fontsa1/KRIA-Based-Bathymetric-Surveying-ASV/Part List.docx

Purchase prices checked 28 Sep 2026, before shipping and tax.

Sonar Sensor:

BlueRobotics Ping2 echosounder/altimeter

https://bluerobotics.com/store/sonars/echosounders/ping-sonar-r2-rp/

Purchase: already have (from the old boat)

Path:

USB, USB -> serial adapter

https://bluerobotics.com/store/comm-control-power/tether-interface/bluart-r1-rp/

Purchase: $56 at Blue Robotics (link above)

Thruster:

BlueRobotics T200 thruster 1x

https://bluerobotics.com/store/thrusters/t100-t200-thrusters/t200-thruster-r2-rp/

Purchase: $230 at Blue Robotics (link above)

Path:

PWM from the interface board's mux (KR260 or RC receiver) -> Basic ESC -> thruster

Thruster ESC:

BlueRobotics Basic ESC 1x

https://bluerobotics.com/store/thrusters/speed-controllers/besc30-r3/

Purchase: $40 at Blue Robotics (link above)

(the team already has one, on the existing thruster; the boat needs two)

Path:

Signal: PWM from the interface board's mux (3-pin servo lead, signal and ground only)

Power: 30 A circuit on the fuse block; re-crimp the 14 AWG power leads with #8 ring terminals

Motor: solder the three motor wires to the thruster's wires

GPS:

u-blox NEO

https://gnss.store/products/elt0380

Purchase: €89.99 at GNSS Store, shipped from the EU (link above)

Path:

USB-C, to the shore laptop (the GPS stays off the boat)

GPS Antenna:

Adafruit active GPS antenna (28 dB, 5 m cable, SMA, magnetic base) 1x

https://www.adafruit.com/product/960

Purchase: $21.50 at Adafruit (link above)

(not rated waterproof; the IP67 u-blox ANN-MB-00, €53.80 at ArduSimple, is the upgrade)

Path:

SMA male, 5 m cable -> the GPS receiver's SMA connector

LIDAR:

https://www.dfrobot.com/product-2616.html

Purchase: $399 at DFRobot (link above)

Path:

TTL UART, ships with a USB adapter and micro-USB cable

Power: the kit's power cable from the USB charger (Blue Sea 1045)

Synthetic GPS:

Marvelmind Super-Beacon

https://www.robotshop.com/products/marvelmind-super-beacon-45khz?qd=e18b03a20aebe5a5d66a8ae218f72a98

Purchase: already have

Path:

Virtual UART via USB

Marvelmind Modem:

Marvelmind Modem HW v5.1

https://marvelmind.com/product/modem-hw-v5-1/

Purchase: $119 at Marvelmind, only if the set is missing it (link above)

(comes in the Starter Set Super-MP-3D; buy one only if the team's set is missing it)

Path:

USB to the shore laptop (Marvelmind Dashboard) for setup; a USB power bank keeps it on during a survey

Number of stationary beacons still depends on the survey area (plan §8.1)

RC Reciever:

RadioMaster ER8 ELRS PWM receiver 1x

https://radiomasterrc.com/products/er8-2-4ghz-elrs-pwm-receiver

Purchase: $34.99 at RadioMaster; US hobby stores charge $41.99 (link above)

Path:

PWM outputs -> interface board: left thrust, right thrust, SEL (mode switch), survey button

Power: 5 V from the 5 V BEC, through the interface board

RC Transmitter:

RadioMaster Pocket, ELRS version 1x

https://radiomasterrc.com/products/pocket-radio-controller-m2

Purchase: $71.50 at RadioMaster; choose the ELRS / FCC version (link above)

RadioMaster 18650 3200mAh batteries (2 pack) 1x

https://radiomasterrc.com/products/18650-3200mah-3-7v-battery-2pcs-for-tx16s-boxer-tx12-mt12-radios

Purchase: $11.99 at RadioMaster, in the same order as the radio (link above)

(the Pocket takes two 18650 cells, not included; RadioMaster only ships batteries with a radio, so order them together)

Path:

2.4 GHz ELRS radio link -> ER8 receiver

Camera:

Luxonis Oak D

https://shop.luxonis.com/products/oak-d

Purchase: $329 at Luxonis (link above); model not chosen yet, but the OAK-D S2 the plan recommends is also $329

Path:

USB3

Heading Source:

Not decided yet (plan §4)

Options: Marvelmind paired beacons (a second hedgehog on the boat), an external compass/IMU, or the OAK-D's built-in IMU

Purchase: waits on the choice

Path:

Depends on the choice; USB for all three options

Computer:

AMD Kria KR260 Robotics Starter Kit

https://www.amd.com/en/products/system-on-modules/kria/k26/kr260-robotics-starter-kit.html

Purchase: already have

(already have)

Path:

Power: 12 V from the 12 V regulator into its DC jack (J12)

USB0: powered USB hub (sensors) and the WiFi adapter; USB1: camera

PMOD J2: interface board (thruster PWM out, survey button in); PMOD J18: e-stop switch

WiFi Adapter:

Alfa AWUS036ACM (MediaTek MT7612U chipset) 1x

https://store.rokland.com/products/alfa-awus036acm-802-11ac-dual-band-2-4-5-ghz-wifi-usb-adapter

Purchase: $46.97 at Rokland, Alfa's US distributor (link above)

(install the MT7612U firmware on the KR260 first; the trimmed image has none)

Path:

KR260 USB0, port B; hosts the field WiFi network on 5 GHz for SSH (plan §3.1)

PWM Multiplexer:

Pololu 4-Channel RC Servo Multiplexer, partial kit (#2807) 1x

https://www.pololu.com/product/2807

Purchase: $16.95 at Pololu (link above)

Path:

Soldered onto the interface board: RC receiver -> master inputs, KR260 -> slave inputs, outputs -> Basic ESCs

Power: 5 V from the 5 V BEC, through the interface board (never battery voltage)

Interface Board:

TI SN74AHCT125N buffer 1x

https://www.ti.com/product/SN74AHCT125/part-details/SN74AHCT125N

Purchase: under $1 at DigiKey

https://www.digikey.com/en/products/detail/texas-instruments/SN74AHCT125N/375798

14-pin DIP socket 1x

Purchase: about $1 at DigiKey (Mill-Max 110-44-314-41-001000)

https://www.digikey.com/en/products/detail/mill-max-manufacturing-corp/110-44-314-41-001000/947057

10 kΩ resistor 7x (5 on the board, 2 spliced in at the ESC ends of the signal leads)

Purchase: $0.75 for a pack of 25 at Adafruit

https://www.adafruit.com/product/2784

2.2 kΩ resistor 1x

Purchase: $0.75 for a pack of 25 at Adafruit

https://www.adafruit.com/product/2782

0.1 µF ceramic capacitor 1x

Purchase: $1.95 for a pack of 10 at Adafruit

https://www.adafruit.com/product/753

10–100 µF electrolytic capacitor 1x

Purchase: under $1 at DigiKey (Panasonic ECA-1EM470, 47 µF 25 V)

https://www.digikey.com/en/products/detail/panasonic-industry/ECA-1EM470/245010

Perfboard 1x

Purchase: $12.50 for a 3-pack of Perma-Proto half-size boards at Adafruit

https://www.adafruit.com/product/571

0.1" male headers (as needed)

Purchase: $4.95 for a pack of 10 strips at Adafruit

https://www.adafruit.com/product/392

4-pin JST-XH connector pair 1x

Purchase: $0.95 for a pre-wired pair at Adafruit

https://www.adafruit.com/product/4874

(the Adafruit parts can share one order with the GPS antenna, and the DigiKey parts with the 2 A fuses; skip any generic parts the lab already stocks)

Path:

RC receiver and KR260 in, Basic ESCs out; wiring diagram in plan §13.7

Cable to KR260 PMOD J2: 4 wires (PWM left, PWM right, survey button, ground), JST-XH at the board end

Power: 5 V from the 5 V BEC's servo lead

E-Stop:

Not decided yet (plan §13.4, §15.5)

Recommended: a relay or contactor rated for the thruster current that cuts power to the two ESCs only, plus a switch into PMOD J18

Purchase: waits on the cut-point decision

Path:

Between the fuse block and the two ESC circuits (if the recommendation is chosen)

Batteries:

5S lithium battery packs, wired in parallel

(already have two; one is swollen and has to be retired)

Replacement pack: match the chemistry and capacity on the labels, which still need to be read

Path:

Packs in parallel -> main fuse -> e-stop -> fuse block

Main Fuse:

Blue Sea 7720 AMI/MIDI Safety Fuse Block 1x

https://www.bluesea.com/products/7720/AMI___MIDI_Safety_Fuse_Block

Purchase: $41.04 at Hodges Marine

https://www.hodgesmarine.com/blu7720-blue-sea-7720-midiami-safety-fuse-block.html

Blue Sea 5255 AMI/MIDI fuse, 80 A 2x (one spare; the 60 A version, 5253, also fits the plan's 60–80 A)

https://www.bluesea.com/products/5255/AMI___MIDI_Fuse_-_80_Amp

Purchase: $14.95 for a pair at Hodges Marine

https://www.hodgesmarine.com/blu5255-blue-sea-5255-midiami-fuse-80-amp.html

Path:

In the positive main line, as close to the battery as possible (8–10 AWG)

Fuse Block:

Blue Sea 5025 blade fuse block (6 circuits, negative bus, cover) 1x

https://www.bluesea.com/products/5025/ST_Blade_Fuse_Block_-_6_Circuits_with_Negative_Bus_and_Cover

Purchase: $42.79 at Powerwerx (listed as 5025B, the same block in bulk packaging)

https://powerwerx.com/blue-sea-5025-6-circuit-fuse-block

Path:

Main fuse -> fuse block -> ESC L (30 A), ESC R (30 A), 12 V regulator (5 A), USB charger (5 A), 5 V BEC (2 A), 1 spare

Negative bus = common ground; each branch's ground wire runs back to it on its own

Fuses:

ATC blade fuses: 30 A 2x, 5 A 2x, 2 A 2x, plus spares

Purchase: 30 A and 5 A are $0.39 each at Powerwerx

https://powerwerx.com/atc-ato-blade-type-fuses

2 A (Powerwerx doesn't stock it): under $1 each at DigiKey (Littelfuse 0ATO002.V)

https://www.digikey.com/en/products/detail/littelfuse-inc/0ATO002-V/2519126

Blue Sea 5065 waterproof in-line ATO/ATC fuse holder 1x

https://www.bluesea.com/products/5065/Waterproof_In-Line_ATO_ATC_Fuse_holder

Purchase: $9.99 at Powerwerx, in the same order as the fuse block

https://powerwerx.com/blue-sea-5065-waterproof-inline-fuse-holder

Path:

Blade fuses go in the fuse block, except one 2 A in the inline holder between the 12 V regulator and the USB hub

12V Regulator:

Pololu D36V50F12 (12 V, 4.5 A step-down) 1x

https://www.pololu.com/product/4095

Purchase: $39.95 at Pololu (link above)

Path:

Fuse block (5 A) -> regulator -> KR260 DC jack, and -> 2 A inline fuse -> powered USB hub

5V BEC:

BlueRobotics 5V 6A Power Supply 1x

https://bluerobotics.com/store/comm-control-power/control/bec-5v6a-r1/

Purchase: $32 at Blue Robotics (link above)

Path:

Fuse block (2 A) -> BEC -> servo lead to the interface board (powers the mux and the RC receiver)

USB Charger:

Blue Sea 1045 12/24V dual USB charger (4.8 A) 1x

https://www.bluesea.com/products/1045/12_24V_DC_Dual_USB_Charger_4.8A_with_Intelligent_Device_Recognition

Purchase: $46.09 at Hodges Marine

https://www.hodgesmarine.com/blu1045-blue-sea-1045-1224v-dual-usb-charger-118-s.html

Path:

Fuse block (5 A) -> charger -> lidar's USB adapter (power only); second port for the optional camera Y-adapter

Powered USB Hub:

StarTech ST4200USBM 4-port industrial USB hub 1x

https://www.startech.com/en-us/cards-adapters/st4200usbm

Purchase: $83.99 at CDW

https://www.cdw.com/product/startech-4-port-usb-2.0-hub-metal-industrial-usb-a-hub-din-rail-wall-o/1627135

Path:

Power: 12 V from the 12 V regulator, through the 2 A inline fuse (screw terminal, 7–24 V)

USB: upstream -> KR260 USB0; downstream -> sonar (BLUART), lidar USB adapter, Marvelmind hedgehog

Camera Power Adapter (optional):

Luxonis OAK Y-adapter

https://shop.luxonis.com/products/oak-y-adapter

Purchase: $24 at Luxonis (link above)

Path:

Data -> KR260 USB1; power -> the USB charger's second port

Power Cables:

BNTECHGO 8 AWG tinned silicone wire, 5 ft red + 5 ft black 1x

Purchase: $17.98 at BNTECHGO

https://bntechgo.com/bntechgo-8-gauge-silicone-wire-kit-ultra-flexible-10-feet-black-and-red-each-color-5-ft-high-temp-200-c-600v-8-awg-silicone-wire-with-1650-stran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

BNTECHGO 16 AWG tinned silicone wire, 10 ft red + 10 ft black 1x

Purchase: $9.83 at BNTECHGO

https://bntechgo.com/bntechgo-16-gauge-silicone-wire-kit-ultra-flexible-20-ft-black-and-red-each-color-10-ft-high-temp-200-c-600v-16-awg-silicone-wire-252-strands-of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

BNTECHGO 12 AWG tinned silicone wire, 3 ft red + 3 ft black 1x (only if the ESCs' own 14 AWG leads don't reach the fuse block)

Purchase: $8.35 at BNTECHGO

https://bntechgo.com/bntechgo-12-gauge-silicone-wire-kit-ultra-flexible-6-ft-black-and-red-each-color-3-ft-high-temp-200-c-600v-12-awg-silicone-wire-680-strands-of-t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

Tinned 8 AWG lugs: 5/16" 2x (main fuse holder's M8 studs), #10 2x (fuse block's positive feed and negative bus studs)

Purchase: $1.39 each at Powerwerx

https://powerwerx.com/ancor-tinned-marine-lug-terminals

(8 AWG lugs need a heavy-duty or hammer crimper; check what the lab has. Silicone insulation is soft, so run the wire through a grommet or split loom wherever it crosses an edge)

Path:

8 AWG red: battery + -> main fuse -> e-stop -> fuse block positive stud

8 AWG black: battery − -> fuse block negative bus

16 AWG: fuse block -> 12 V regulator (5 A), USB charger (5 A), and 5 V BEC (2 A); each branch's black wire runs back to the negative bus on its own

16 AWG: 12 V regulator -> KR260 barrel plug, and -> 2 A inline fuse -> USB hub terminal

ESCs: their own 14 AWG leads to the two 30 A circuits; if they're too short, solder on 12 AWG and heat-shrink the joint

Already cabled: the BEC's servo lead to the interface board, the ESC signal leads, and the lidar's USB power cord

Wiring and Connectors:

#8 ring terminals for 14 AWG 4x (re-crimping the two ESCs' power leads)

Purchase: $0.23 each at Powerwerx (heat-shrink, #8, blue 16–14 AWG)

https://powerwerx.com/heat-shrink-adhesive-ring-terminals

Ring terminals for the other branches: #8 for the fuse block's circuit screws, #10 for its studs

Purchase: same Powerwerx page, $0.18–0.25 each depending on wire gauge

DC barrel plug pigtail for the KR260 (match the plug on the kit's 12 V adapter)

Electrolytic capacitor across the 12 V regulator's input, rated 35 V or more (bulk capacitance against thruster surges)

Battery connectors to match the packs (check the labels)

Heat shrink tubing

(no links yet for the barrel plug, capacitor, or battery connectors: they depend on the kit's adapter plug, a capacitor value, and the battery labels; heat shrink from any hardware store)

(leftover ServoCity servo cables can be reused for signal leads and the 5 V branch)

Path:

Branch-by-branch fuse and wire sizes in plan §15.4

Hull and Enclosure:

Boogie board hull

Waterproof box(es) for the electronics

Reused 3D-printed brackets

3D-printed camera chassis with an anti-reflective glass panel, hydrophobic coating, and a desiccant pack

Purchase: waits on the mounting design

Path:

Mounting and layout aren't designed yet

Cable Penetrators:

BlueRobotics WetLink Penetrator, M10-6.5mm-LC 2x

https://bluerobotics.com/store/cables-connectors/penetrators/wlp-vp/

Purchase: $13 each at Blue Robotics; choose the M10-6.5mm-LC option (link above)

(one per thruster cable; the sonar's cable already has an M10-4.5mm-LC fitted and only needs an M10 hole)

Path:

Thruster and sonar cables through the electronics box wall

Still to choose: how the lidar, camera, Marvelmind hedgehog, RC receiver antennas, and WiFi antenna get out of the box
