fontsa1/KRIA-Based-Bathymetric-Surveying-ASV/(commit log)

2026-09-17 added telemetry plan and potential sensor list
2026-09-19 added section on thruster configuration/control
2026-09-20 updated the sensor list
2026-09-25 added power distribution section
2026-09-25 udpated power section
2026-09-27 updated section on usb power, added interface board to section 13
2026-10-29 Add ROS2 sonar node; Add SoC sharing file scripts; Add SoC shared files from PWM
